ZZ8874-001/Armor_Cmzy26_081/Docs/SCH_Armor_Sc_EVE_081_2026-08-20.pdf

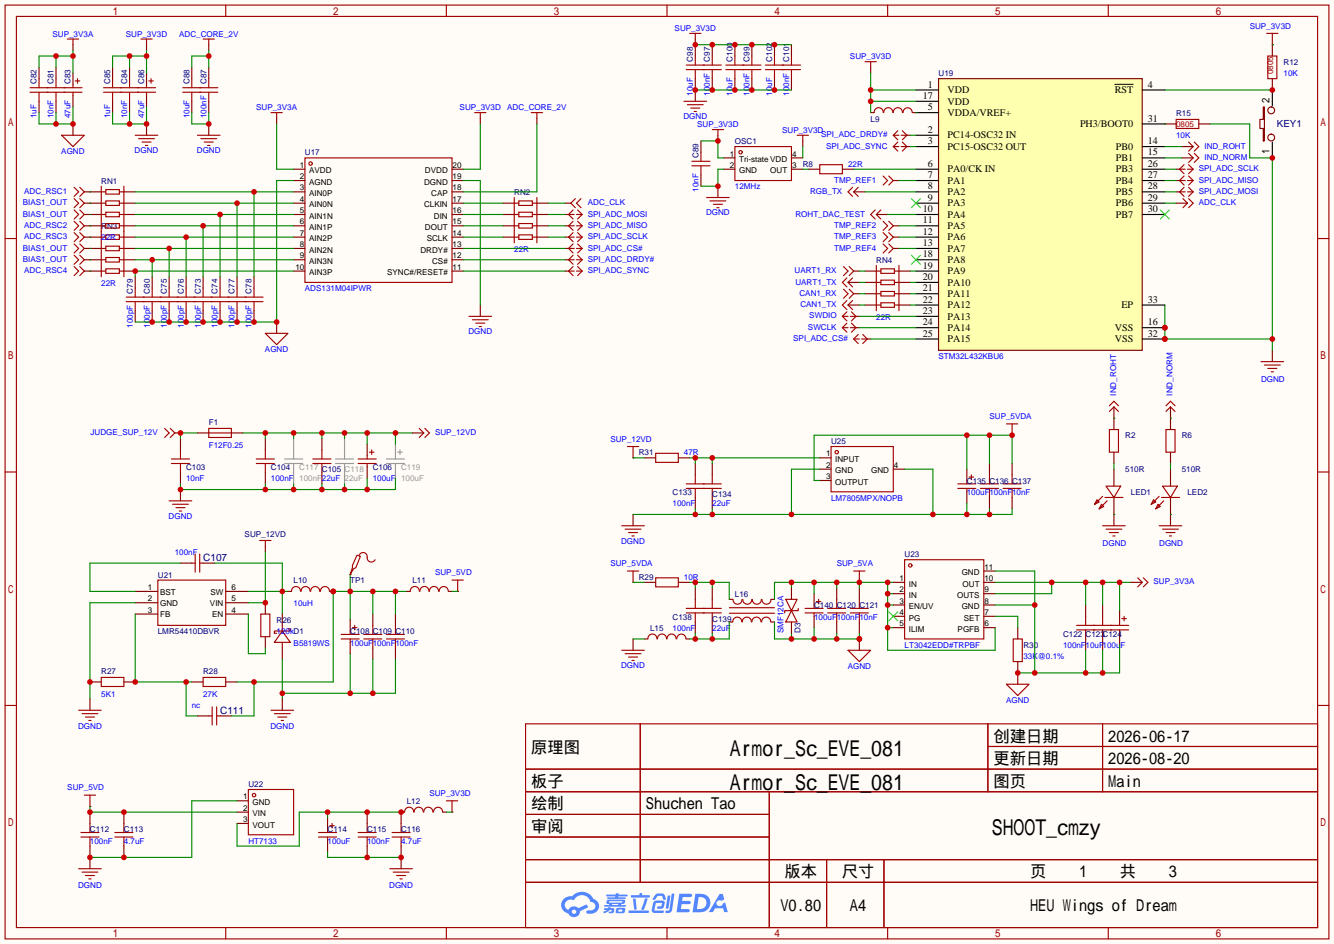
[picture p1: page 1]

原理图 | Armor_Sc_EVE_081 | 创建日期 | 2026-06-17

更新日期 | 2026-08-20

板子 | Armor_Sc_EVE_081 | 图页 | Main

V0.80 | A4 | HEU Wings of Dream

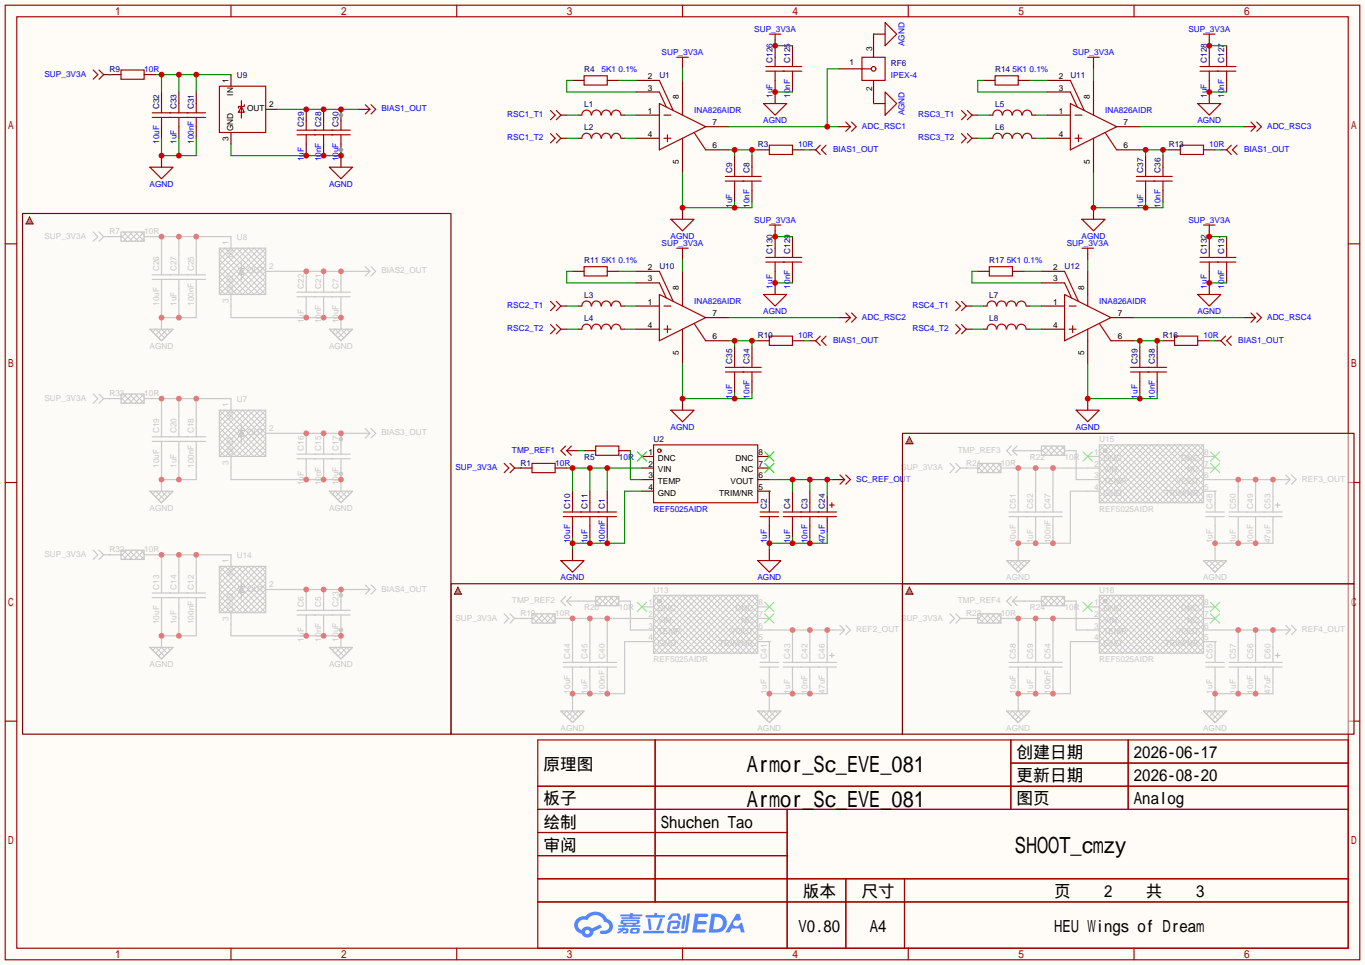
[picture p2: page 2]

原理图 | Armor_Sc_EVE_081 | 创建日期 | 2026-06-17

更新日期 | 2026-08-20

板子 | Armor_Sc_EVE_081 | 图页 | Analog
绘制 | Shuchen Tao | SHOOT_cmzy
审阅

## CN1WAFER⁻GH¹.25⁻3PWB

## U18WAFER⁻GH¹.25⁻4PWB

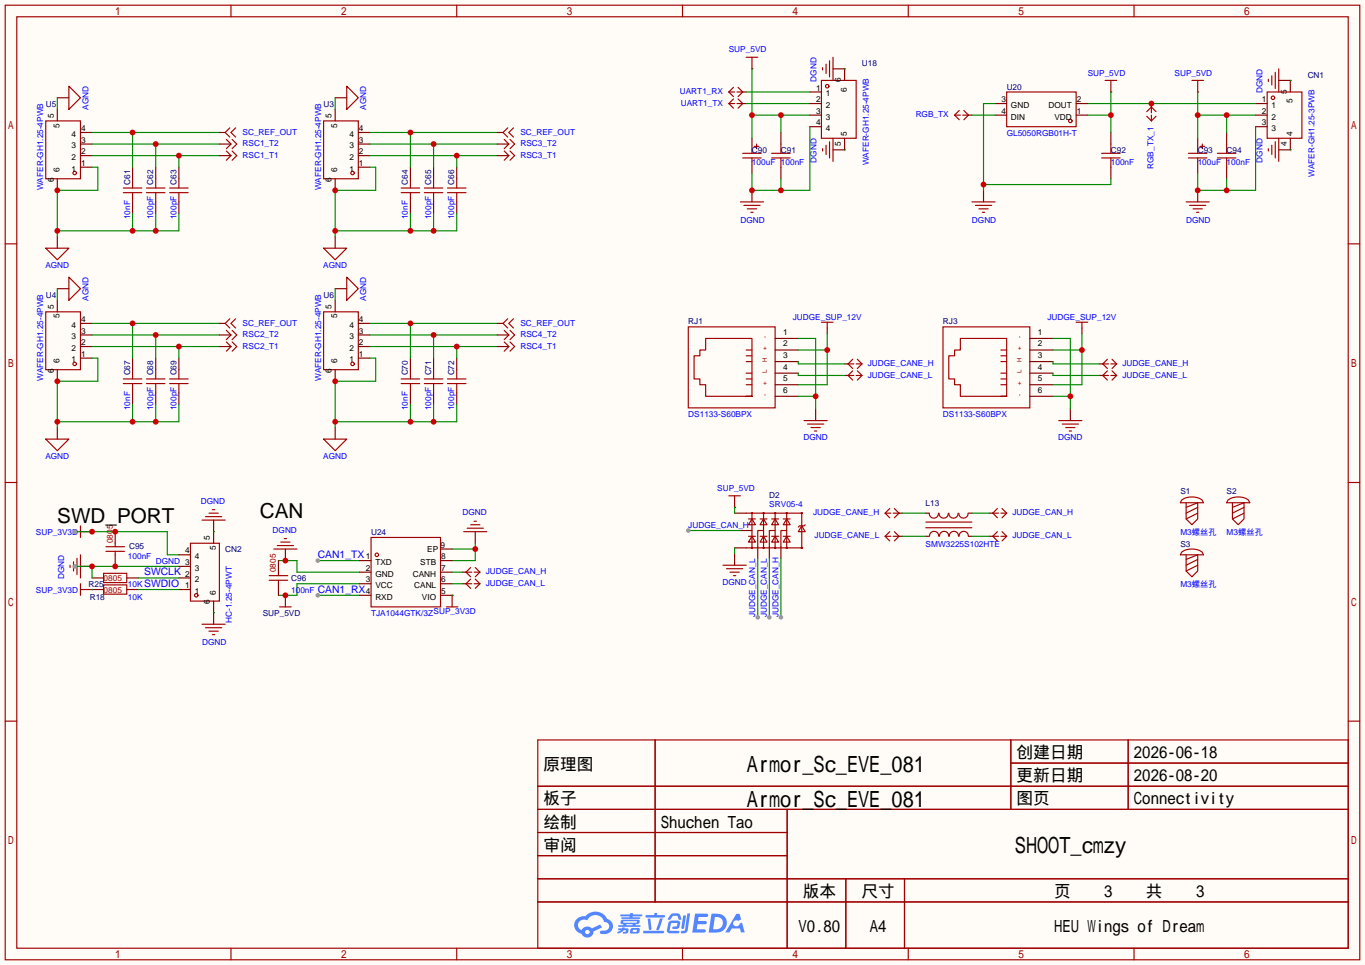
[picture p3: page 3]

原理图 | Armor_Sc_EVE_081 | 创建日期 | 2026-06-18

更新日期 | 2026-08-20

板子 | Armor_Sc_EVE_081 | 图页 | Connectivity
绘制 | Shuchen Tao | SHOOT_cmzy
审阅
