ZZ8874-001/Armor_Cmzy26_081/Armor_Cmzy26_081.ioc

Mcu.UserName=STM32L432KBUx
PA0.Signal=RCC_CK_IN
PA1.Signal=ADCx_IN6
PA10.Signal=USART1_RX
PA11.Signal=CAN1_RX
PA12.Signal=CAN1_TX
PA2.Signal=USART2_TX
PA3.GPIO_Label=PA3_NC
PA3.Signal=GPIO_Analog
PA4.GPIO_Label=ROHT_DAC_TEST_NC
PA4.Signal=SharedAnalog_PA4
PA5.GPIO_Label=TMP_REF2_NC
PA5.Signal=SharedAnalog_PA5
PA6.GPIO_Label=TMP_REF3_NC
PA6.Signal=SharedAnalog_PA6
PA7.GPIO_Label=TMP_REF4_NC
PA7.Signal=SharedAnalog_PA7
PA8.GPIO_Label=PA8_NC
PA8.Signal=GPIO_Analog
PA9.Signal=USART1_TX
PB0.GPIO_Label=IND_ROHT
PB0.Signal=GPIO_Output
PB1.GPIO_Label=IND_NORM
PB1.Signal=GPIO_Output
PB5.Signal=SPI1_MOSI
PB6.GPIO_Label=ADC_CLK
PB6.Signal=TIM16_CH1N
PB7.GPIO_Label=PB7_NC
PB7.Signal=GPIO_Analog
