ZZ8874-001/Armor_Cmzy26_081/Core/Inc/main.h

#define ADC_CS_Pin GPIO_PIN_14
#define ADC_CS_GPIO_Port GPIOC
#define ADC_SYNC_Pin GPIO_PIN_15
#define ADC_SYNC_GPIO_Port GPIOC
#define PA3_NC_Pin GPIO_PIN_3
#define PA3_NC_GPIO_Port GPIOA
#define ROHT_DAC_TEST_NC_Pin GPIO_PIN_4
#define ROHT_DAC_TEST_NC_GPIO_Port GPIOA
#define TMP_REF2_NC_Pin GPIO_PIN_5
#define TMP_REF2_NC_GPIO_Port GPIOA
#define TMP_REF3_NC_Pin GPIO_PIN_6
#define TMP_REF3_NC_GPIO_Port GPIOA
#define TMP_REF4_NC_Pin GPIO_PIN_7
#define TMP_REF4_NC_GPIO_Port GPIOA
#define IND_ROHT_Pin GPIO_PIN_0
#define IND_ROHT_GPIO_Port GPIOB
#define IND_NORM_Pin GPIO_PIN_1
#define IND_NORM_GPIO_Port GPIOB
#define PA8_NC_Pin GPIO_PIN_8
#define PA8_NC_GPIO_Port GPIOA
#define ADC_NDRDY_Pin GPIO_PIN_15
#define ADC_NDRDY_GPIO_Port GPIOA
#define ADC_NDRDY_EXTI_IRQn EXTI15_10_IRQn
#define ADC_CLK_Pin GPIO_PIN_6
#define ADC_CLK_GPIO_Port GPIOB
#define PB7_NC_Pin GPIO_PIN_7
#define PB7_NC_GPIO_Port GPIOB
