ZZ8874-001/Armor_Cmzy26_081/(commit log)

2026-08-20 新建文件夹 硬件版本080
2026-08-21 文档和初版必要CubeMX配置
2026-08-23 feat:工程框架验证 已配备全套工程结构文档，单文件内部有todo清单
2026-09-04 feat:M1步，ADS131M04驱动基本完成 详见调试文档
    [Ozone_Watched_Data_1_260904.csv, decoder--260904-182818.csv, decoder--260904-191005.csv, decoder--260904-192800.csv, decoder--260904-194214.csv, decoder--260904-200141.csv]
2026-09-05 feat:RGB&击打检测正常
2026-09-05 feat:CAN通信单侧实现，未进行验证
